gabrielfbdiniz/PFC-Boost-STM32/README.md

# AC-DC 380V Active Boost PFC Converter








Conversor estático de potência CA/CC com **Correção Ativa do Fator de Potência (Active PFC)** na topologia **Boost**, projetado para elevar a tensão da rede elétrica retificada (127V / 220V AC) para um barramento CC estabilizado de **380V DC**.

O controle digital de malha fechada (tensão e corrente em modo de condução contínua - CCM) e gerenciamento de estados é operado por uma plataforma **STM32F103C8T6 (ARM Cortex-M3 a 72 MHz)**, acompanhado de proteções ultrarrápidas de sobrecorrente por hardware e circuito inteligente de pré-carga (*soft-start / inrush current limiting*).

---

## Renderizações 3D do Projeto

| Vista Superior (Top View) | Vista Inferior (Bottom View) |
| :---: | :---: |
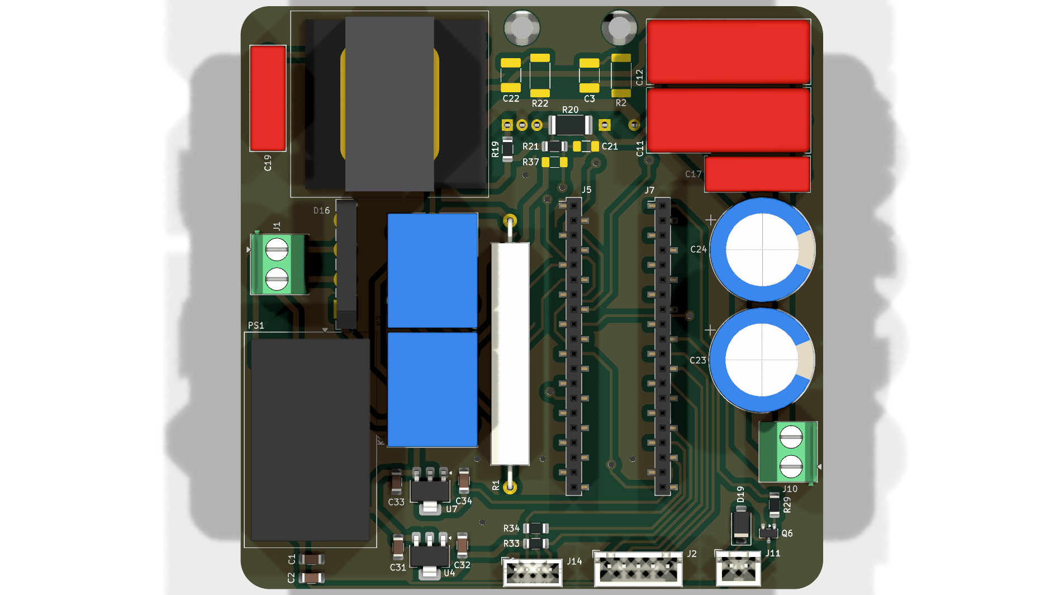
[picture p1: renders/render_top.png]
Top View
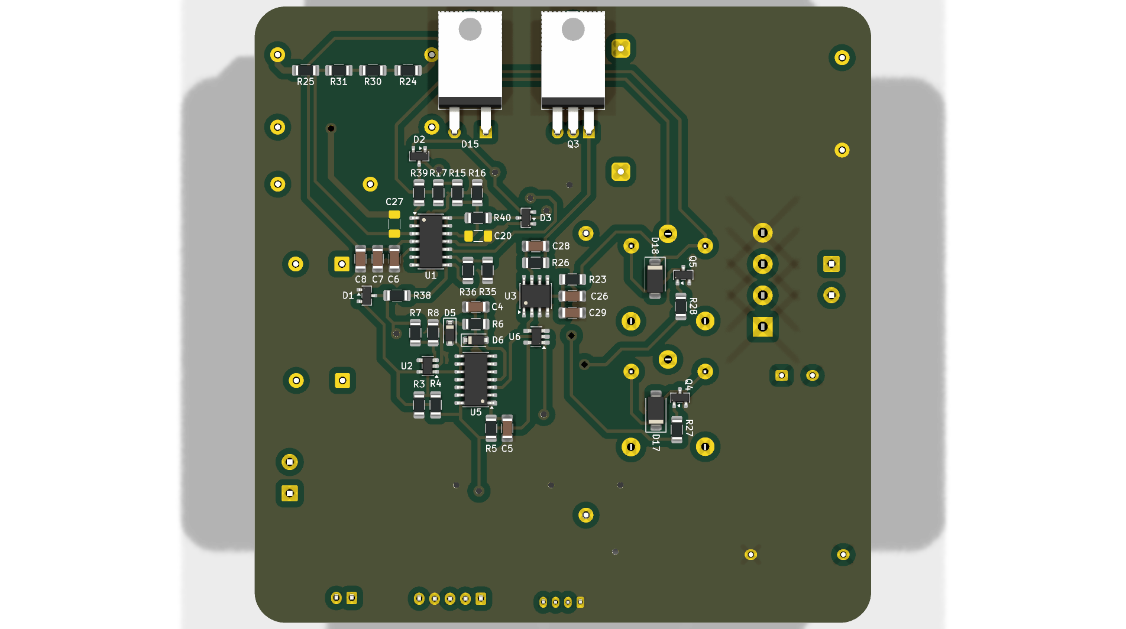
[picture p2: renders/render_bottom.png]
Bottom View
|  |  |

| Perspectiva Superior Isométrica | Perspectiva Inferior Isométrica |
| :---: | :---: |
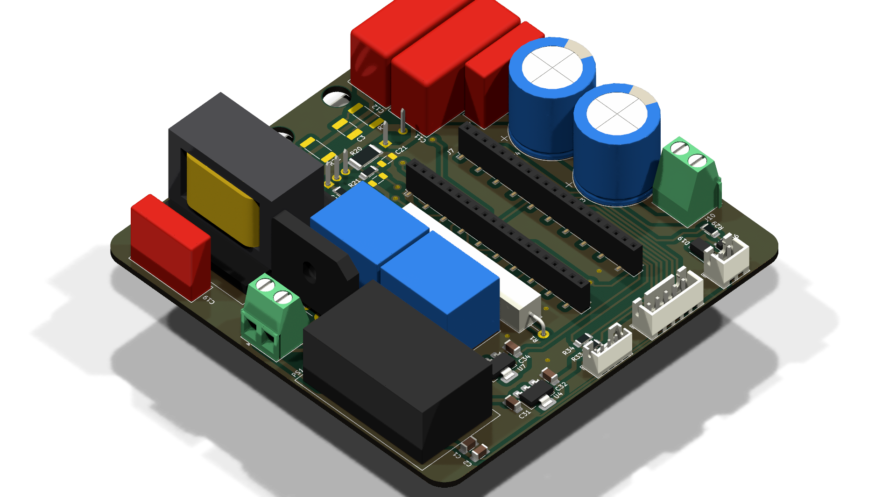
[picture p3: renders/render_iso_top.png]
Top Isometric
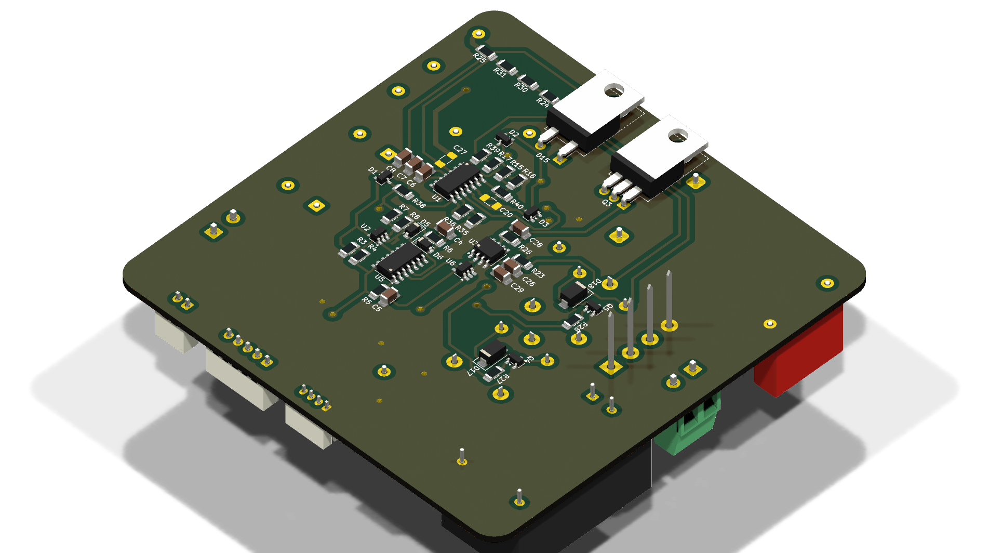
[picture p4: renders/render_iso_bottom.png]
Bottom Isometric
|  |  |

---

## 1. Visão Geral da Arquitetura do Conversor

O sistema é dividido em três blocos funcionais modulares conforme o esquemático hierárquico:
1. **Low Frequency Rectifier & Inrush (`lf_rectifier`):** Ponte retificadora de entrada, relé de bypass de inrush (`RELAY_INRUSH`) e relé mestre de ligamento (`RELAY_ON_OFF`).
2. **Estágio de Potência & Proteção PFC (`pfc`):** Indutor boost, MOSFET de comutação rápida, diodo boost ultrarrápido, gate driver com porta de intertravamento e latch analógico de sobrecorrente em hardware.
3. **Placa de Controle & IHM (`mcu`):** Breakout STM32F103 (Blue Pill), conversores de nível lógico, display I2C, encoder rotativo e acionamento térmico do ventilador.

```mermaid
flowchart LR
    subgraph AC_Input["Entrada de Rede"]
        AC["Rede CA (127V / 220V)"] --> INRUSH["Circuito de Pré-carga & Inrush"]
        INRUSH --> BRIDGE["Ponte Retificadora"]
    end

    subgraph PFC_Stage["Estágio Boost PFC (Alta Tensão)"]
        BRIDGE -->|"V_in retificada"| L["Indutor Boost L1"]
        L --> Q["MOSFET Q3"]
        L --> D["Diodo Boost D15"]
        D --> COUT["Banco Capacitivo (380V DC)"]
        Q --> SHUNT["Sensor de Corrente"]
    end

    subgraph Hardware_Protection["Proteção Hardware OCP"]
        SHUNT --> COMP["Comparador Rápido (LMV7219)"]
        COMP --> LATCH["Latch SR (74HC00)"]
        LATCH -->|"Hard-Trip Inibição"| AND_GATE["Porta AND (74LVC1G08)"]
        AND_GATE --> DRIVER["Gate Driver TC4427"]
        DRIVER --> Q
    end

    subgraph MCU_Control["Controle Digital (STM32 Blue Pill)"]
        COUT -.->|"Sensoriamento Vout (ADC)"| MCU["STM32F103C8T6"]
        BRIDGE -.->|"Sensoriamento Vin (ADC)"| MCU
        SHUNT -.->|"Sensoriamento IL (ADC)"| MCU
        MCU -->|"PWM Alta Frequência"| AND_GATE
        MCU -->|"RESET_OC"| LATCH
        MCU -->|"ENABLE Geral"| AND_GATE
        MCU -->|"Comando Relés"| INRUSH
    end
```

---

## 2. Especificações Técnicas

| Parâmetro | Valor / Faixa | Observações |
| :--- | :--- | :--- |
| **Topologia** | Boost PFC Ativo (CCM) | Fator de Potência $> 0.98$ |
| **Tensão de Entrada ($V_{in}$)** | $127\text{ V}_{\text{RMS}} - 220\text{ V}_{\text{RMS}}$ ($60\text{ Hz}$) | Tensão de pico retificada: $\approx 180\text{ V} - 311\text{ V}$ |
| **Tensão de Saída ($V_{out}$)** | **$380\text{ V DC}$ regulada** | Tensão nominal do barramento CC |
| **Controlador** | STM32F103C8T6 (ARM Cortex-M3) | 72 MHz, 64 KB Flash, ADC 12 bits |
| **Chaveamento Principal** | MOSFET TO-220 + Diodo Boost TO-220 | Dissipadores dimensionados para convecção forçada |
| **Driver de Gate** | Microchip TC4427 + Intertravamento 74LVC1G08 | Resposta sub-microssegundo |
| **Proteção de Sobrecorrente (OCP)** | Comparador LMV7219 + Latch 74HC00 | Desligamento por hardware independente do MCU |
| **Pré-carga de Barramento** | Relés de 2 estágios (`INRUSH` e `ON_OFF`) | Protege diodos e banco capacitivo na energização |
| **Interface do Usuário** | Display I2C + Encoder Rotativo com Push-Button | Navegação de menus, leituras e parametrização |
| **Refrigeração** | Saída controlada de 12V para Ventoinha | Acionamento via transistor comutada por PWM/GPIO |

---

## 3. Pinout & Mapeamento do Microcontrolador (STM32 Blue Pill)

O mapeamento de pinos reflete as conexões reais implementadas nas folhas esquemáticas em [`hardware/`](hardware/) e roteadas na placa de circuito impresso:

### Pinos de Potência, Controle e Atuadores

| Pino Blue Pill | Sinal Associado | Função no Hardware | Descrição / Operação |
| :--- | :--- | :--- | :--- |
| **`PA2`** | `PFC_PWM` | `TIM2_CH3` | Sinal PWM de alta frequência (50 a 100 kHz) para comutação do MOSFET via gate driver |
| **`PB10`** | `RELAY_INRUSH`| GPIO Output | Aciona o relé de limitação de corrente de partida (bypass do termistor NTC) |
| **`PB11`** | `RELAY_ON_OFF`| GPIO Output | Aciona o relé principal de energização da rede CA |
| **`PB12`** | `FAN_CTRL` | GPIO Output | Controle liga/desliga da ventoinha de refrigeração forçada |
| **`PB8`** | `I2C1_SCL` | `I2C1` | Clock do barramento serial I2C (Display OLED 0.96" SSD1306) com pull-up de 4.7kΩ |
| **`PB9`** | `I2C1_SDA` | `I2C1` | Dados do barramento serial I2C (Display OLED 0.96" SSD1306) com pull-up de 4.7kΩ |
| **`PB3`** | `EXP_SCK` | `SPI1_SCK` / GPIO | Barramento de expansão frontal / Interface de usuário (`J2`) |
| **`PB4`** | `EXP_MISO` | `SPI1_MISO` / GPIO | Barramento de expansão frontal / Interface de usuário (`J2`) |
| **`PB5`** | `EXP_MOSI` | `SPI1_MOSI` / GPIO | Barramento de expansão frontal / Interface de usuário (`J2`) |
| **`PA15`** | `EXP_CS` | GPIO Output | Chip-select para periféricos de expansão no conector `J2` |

### Sensoriamento Analógico e Medição

| Pino Blue Pill | Sinal Associado | Função no Hardware | Descrição / Operação |
| :--- | :--- | :--- | :--- |
| **`PA7`** | `PFC_IL` | `ADC1_IN7` | Sensoriamento analógico da corrente no indutor boost (amplificador de shunt) |
| **`PB0`** | `PFC_VOUT`| `ADC1_IN8` | Sensoriamento da tensão de saída do barramento CC estabilizado (380V) |
| **`PB1`** | `PFC_VIN` | `ADC1_IN9` | Sensoriamento da tensão senoidal retificada de entrada |
| **`PC13`** | *LED Onboard* | GPIO Output | LED indicador de batimento cardíaco (*heartbeat*) e status operacional |
| **`PA13`/`PA14`** | `SWD` | `SWDIO` / `SWCLK` | Interface de gravação e depuração em tempo real com ST-Link v2 |

## 4. Circuitos de Proteção e Segurança em Hardware

1. **Proteção Ultrarrápida de Sobrecorrente (Hardware Trip):**
   * Em conversores boost, sobrecorrentes na chave podem queimar semicondutores em microssegundos.
   * O sinal do resistor shunt de corrente é monitorado continuamente pelo comparador analógico **LMV7219** (`U2`).
   * A saída do comparador aciona imediatamente um **Latch SR implementado com portas NAND 74HC00** (`U5`), travando a saída em nível lógico baixo e cortando a porta AND `74LVC1G08` (`U6`) antes mesmo do firmware do MCU tomar conhecimento.
   * O destravamento após mitigação só ocorre mediante pulso explícito do pino `RESET_OC`.

2. **Sequenciamento de Energização e Pré-Carga:**
   * Na energização inicial, o relé `RELAY_INRUSH` comuta o fluxo de corrente por resistores limitadores de alta potência até os capacitores de saída carregarem sem picos destrutivos.
   * Ao atingir o patamar nominal de entrada, o relé mestre `RELAY_ON_OFF` fecha o circuito em paralelo e o conversor pode ser habilitado com segurança.

---

## 5. Estrutura do Repositório

```text
├── hardware/                   # Projeto de Hardware no KiCad 10
│   ├── 3d/                     # Modelos CAD 3D dos componentes (STEP / WRL)
│   │   ├── Capacitor_THT_L28.0mm_W11.0mm_P25.00mm.step # Modelo 3D dos capacitores C11 e C12
│   │   ├── Inductor_NEE-30-15-15.step                  # Modelo 3D do indutor boost L1 (NEE-30)
│   │   └── ...                 # Modelos adicionais (STM32 Blue Pill, bornes, conectores)
│   ├── lf_rectifier.kicad_sch  # Sub-folha: Retificação de baixa frequência e inrush
│   ├── mcu.kicad_sch           # Sub-folha: Módulo MCU Blue Pill e conexões de IHM
│   ├── pfc.kicad_sch           # Sub-folha: Estágio Boost PFC de 380V e circuitos de proteção
│   ├── power-supply.kicad_pcb  # Layout e roteamento completo da PCB
│   ├── power-supply.kicad_pro  # Arquivo de gerenciamento do projeto KiCad 10
│   └── power-supply.kicad_sch  # Esquemático principal (Top-Level Sheet)
├── firmware/                   # Firmware embarcado para STM32F103 (STM32CubeIDE 1.19)
│   └── README.md               # Guia de configuração, pinout, FSM e arquitetura
├── simulation/                 # Simulação computacional e controle
│   └── simulate_pfc_control.py # Comparação de malhas de controle (Cascata Energia vs. Jacobiano)
├── docs/                       # Documentação técnica e esquemáticos vetoriais
│   ├── PFC_380V_Schematic.pdf  # Esquemático completo exportado em PDF vetorial
│   └── pfc_control_comparison.png # Gráficos comparativos de controle
├── renders/                    # Renders 3D fotorrealistas em alta resolução (1080p)
│   ├── render_top.png
│   ├── render_bottom.png
│   ├── render_iso_top.png
│   └── render_iso_bottom.png
├── .gitignore                  # Filtro para temporários, builds e caches
├── LICENSE                     # Licença de Hardware Aberto CERN-OHL-S v2
└── README.md                   # Documentação técnica de engenharia
```

---

## 6. Como Abrir e Validar o Projeto

### Pré-requisitos
* **KiCad EDA 10.0+** instalado no sistema.
* **Python 3.10+** (com `numpy` e `matplotlib`) para as simulações numéricas.
* **STM32CubeIDE 1.19** para o desenvolvimento do firmware.

### Regenerar Renderizações 3D (via Linha de Comando)
```bash
kicad-cli pcb render -o renders/render_top.png --width 1920 --height 1080 --side top --quality high hardware/power-supply.kicad_pcb
kicad-cli pcb render -o renders/render_bottom.png --width 1920 --height 1080 --side bottom --quality high hardware/power-supply.kicad_pcb
kicad-cli pcb render -o renders/render_iso_top.png --width 1920 --height 1080 --rotate -45,0,45 --quality high hardware/power-supply.kicad_pcb
kicad-cli pcb render -o renders/render_iso_bottom.png --width 1920 --height 1080 --side bottom --rotate -45,0,45 --quality high hardware/power-supply.kicad_pcb
```

### Exportar Esquemático em PDF
```bash
kicad-cli sch export pdf -o docs/PFC_380V_Schematic.pdf hardware/power-supply.kicad_sch
```

### Executar a Simulação Comparativa de Controle
```bash
python simulation/simulate_pfc_control.py
```

## 7. Licença & Créditos

### Autores & Desenvolvedores
* **Abílio Davi**
* **Gabriel Diniz**
* **Vinicius Moreira**

### Orientação
* **Professor Colombo**
* **Professor Eduardo Lenz**

---

### Licença
Distribuído sob a licença **CERN-OHL-S v2** (*CERN Open Hardware Licence Strongly Reciprocal*). Consulte o arquivo [LICENSE](LICENSE) para mais detalhes.
