gabrielfbdiniz/PFC-Boost-STM32/docs/pfc_control_comparison.png

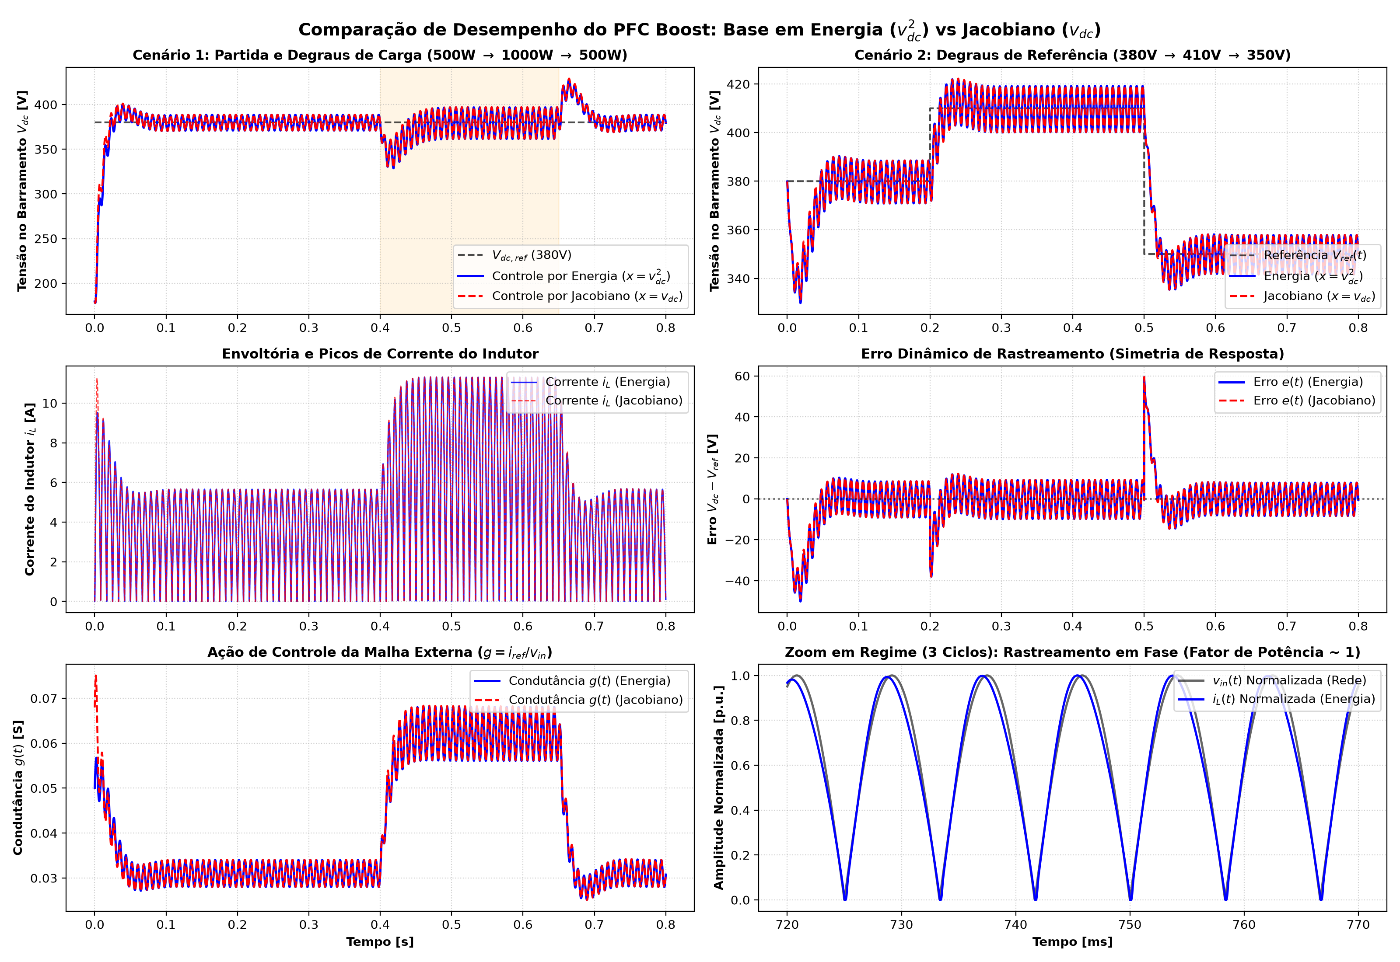
docs/pfc_control_comparison.png
