gabrielfbdiniz/PFC-Boost-STM32/hardware/3d/Capacitor_THT_L28.0mm_W11.0mm_P25.00mm.step

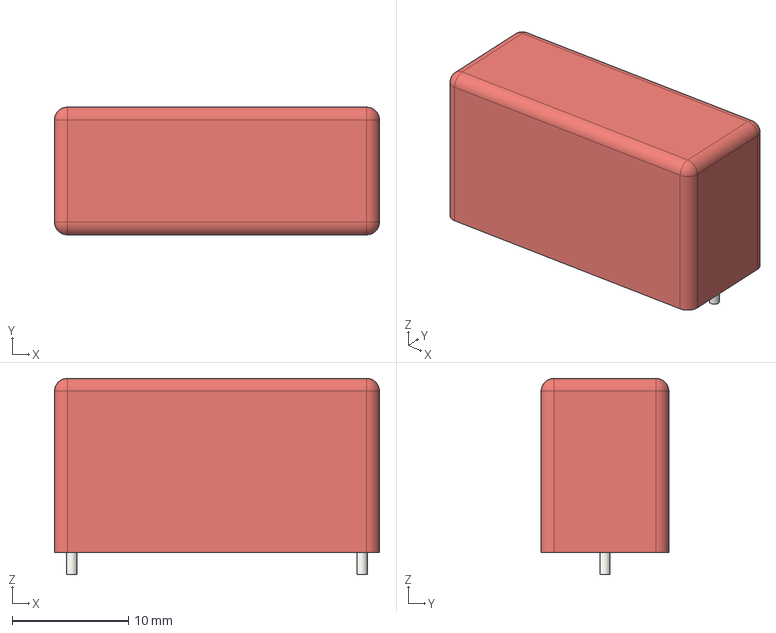
[picture p6: CAD file, 2026-11-01]
hardware/3d/Capacitor_THT_L28.0mm_W11.0mm_P25.00mm.step
28.0 x 11.0 x 16.9 mm
