gabrielfbdiniz/PFC-Boost-STM32/hardware/3d/Inductor_NEE-30-15-15.step

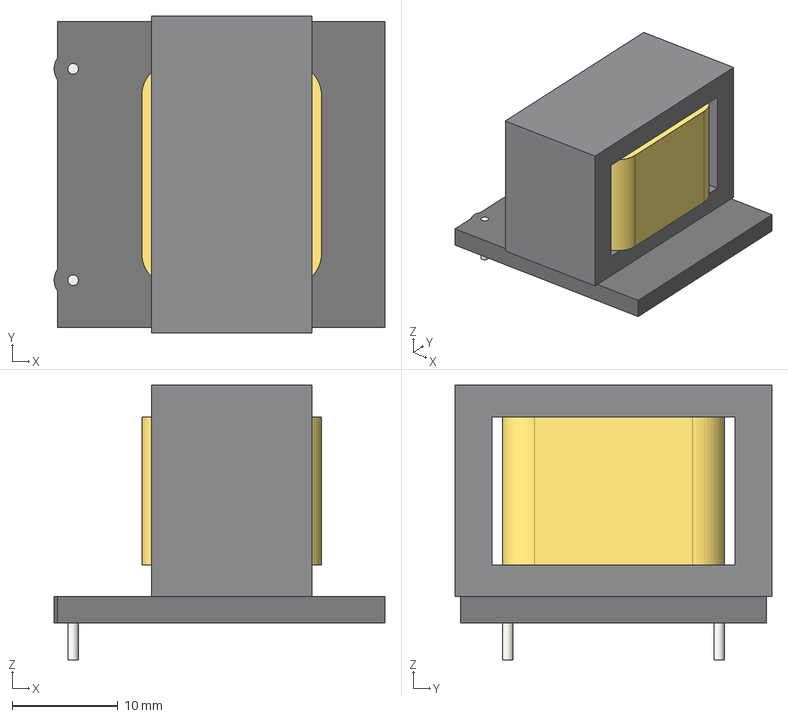
[picture p7: CAD file, 2026-11-01]
hardware/3d/Inductor_NEE-30-15-15.step
31.3 x 30.0 x 26.0 mm
