gabrielfbdiniz/PFC-Boost-STM32/hardware/3d/FuseHolder 5x20mm.step

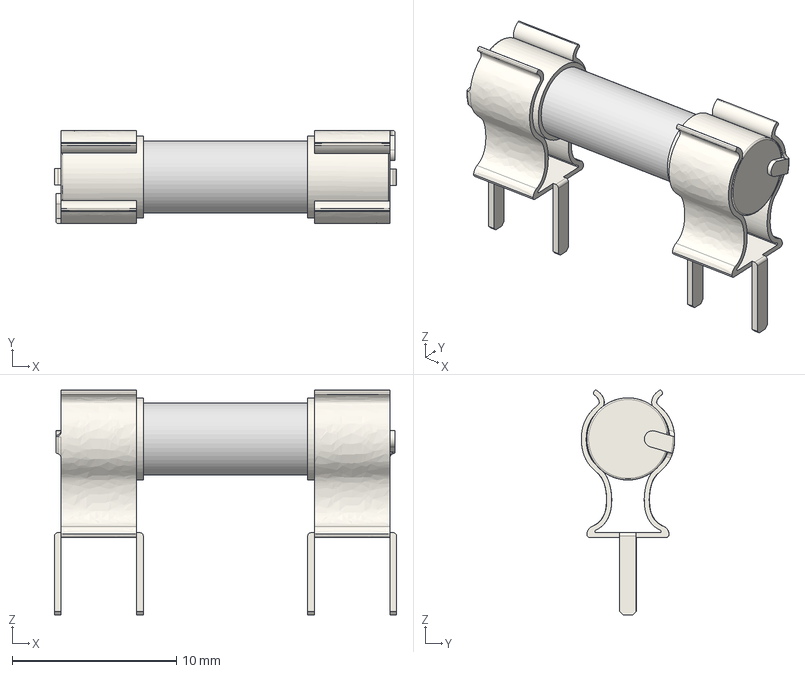
[picture p8: CAD file, 2026-06-02]
hardware/3d/FuseHolder 5x20mm.step
20.8 x 5.68 x 13.7 mm
