gabrielfbdiniz/PFC-Boost-STM32/hardware/3d/Blue Pill STM32.step

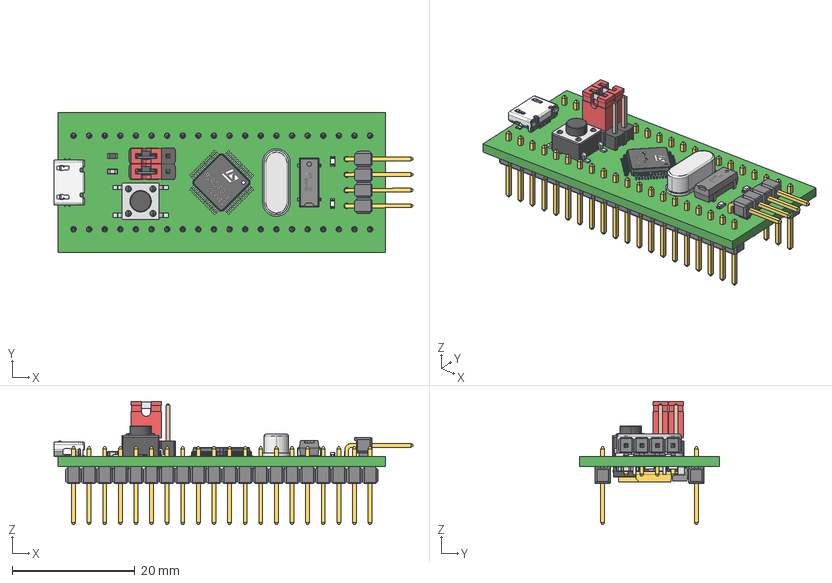
[picture p9: CAD file, 2026-06-02]
hardware/3d/Blue Pill STM32.step
58.4 x 22.9 x 20.1 mm
Pin1 x 12
Pin2 x 12
CeramicBody x 12
RES0603 x 11
pin_header_1x3_and_jumper x 2
STM32-LQFP48
User_Library-mc-306_crystal
USB_micro
User_Library-LED_SMD0603 x 2
C_6032-28 x 8
User_Library-DO-214AC_SMA
CircuitWorks-SOT-223
