gabrielfbdiniz/PFC-Boost-STM32/hardware/3d/DG308-2.54-06P-14-00AH.STEP

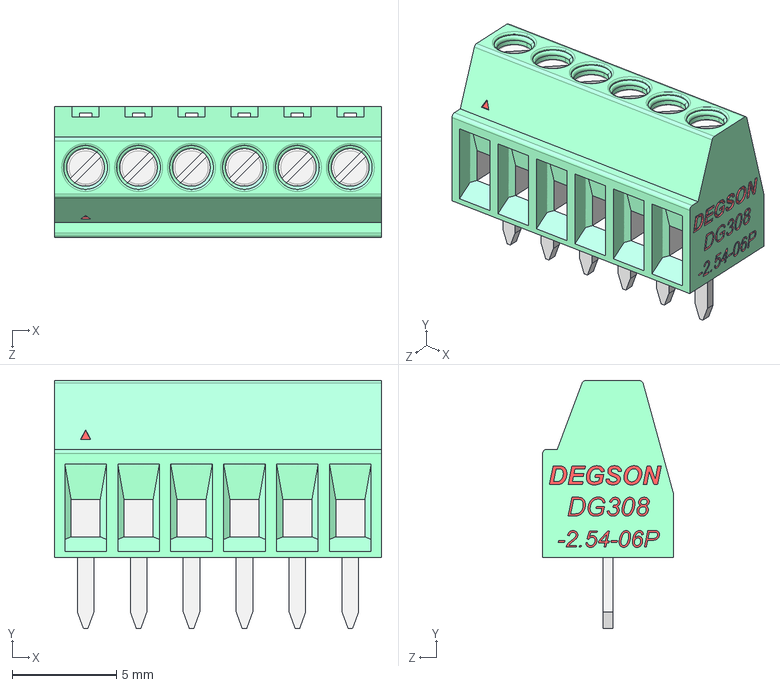
[picture p10: CAD file, 2026-06-02]
hardware/3d/DG308-2.54-06P-14-00AH.STEP
15.7 x 11.9 x 6.27 mm
