gabrielfbdiniz/PFC-Boost-STM32/docs/PFC_380V_Schematic.pdf

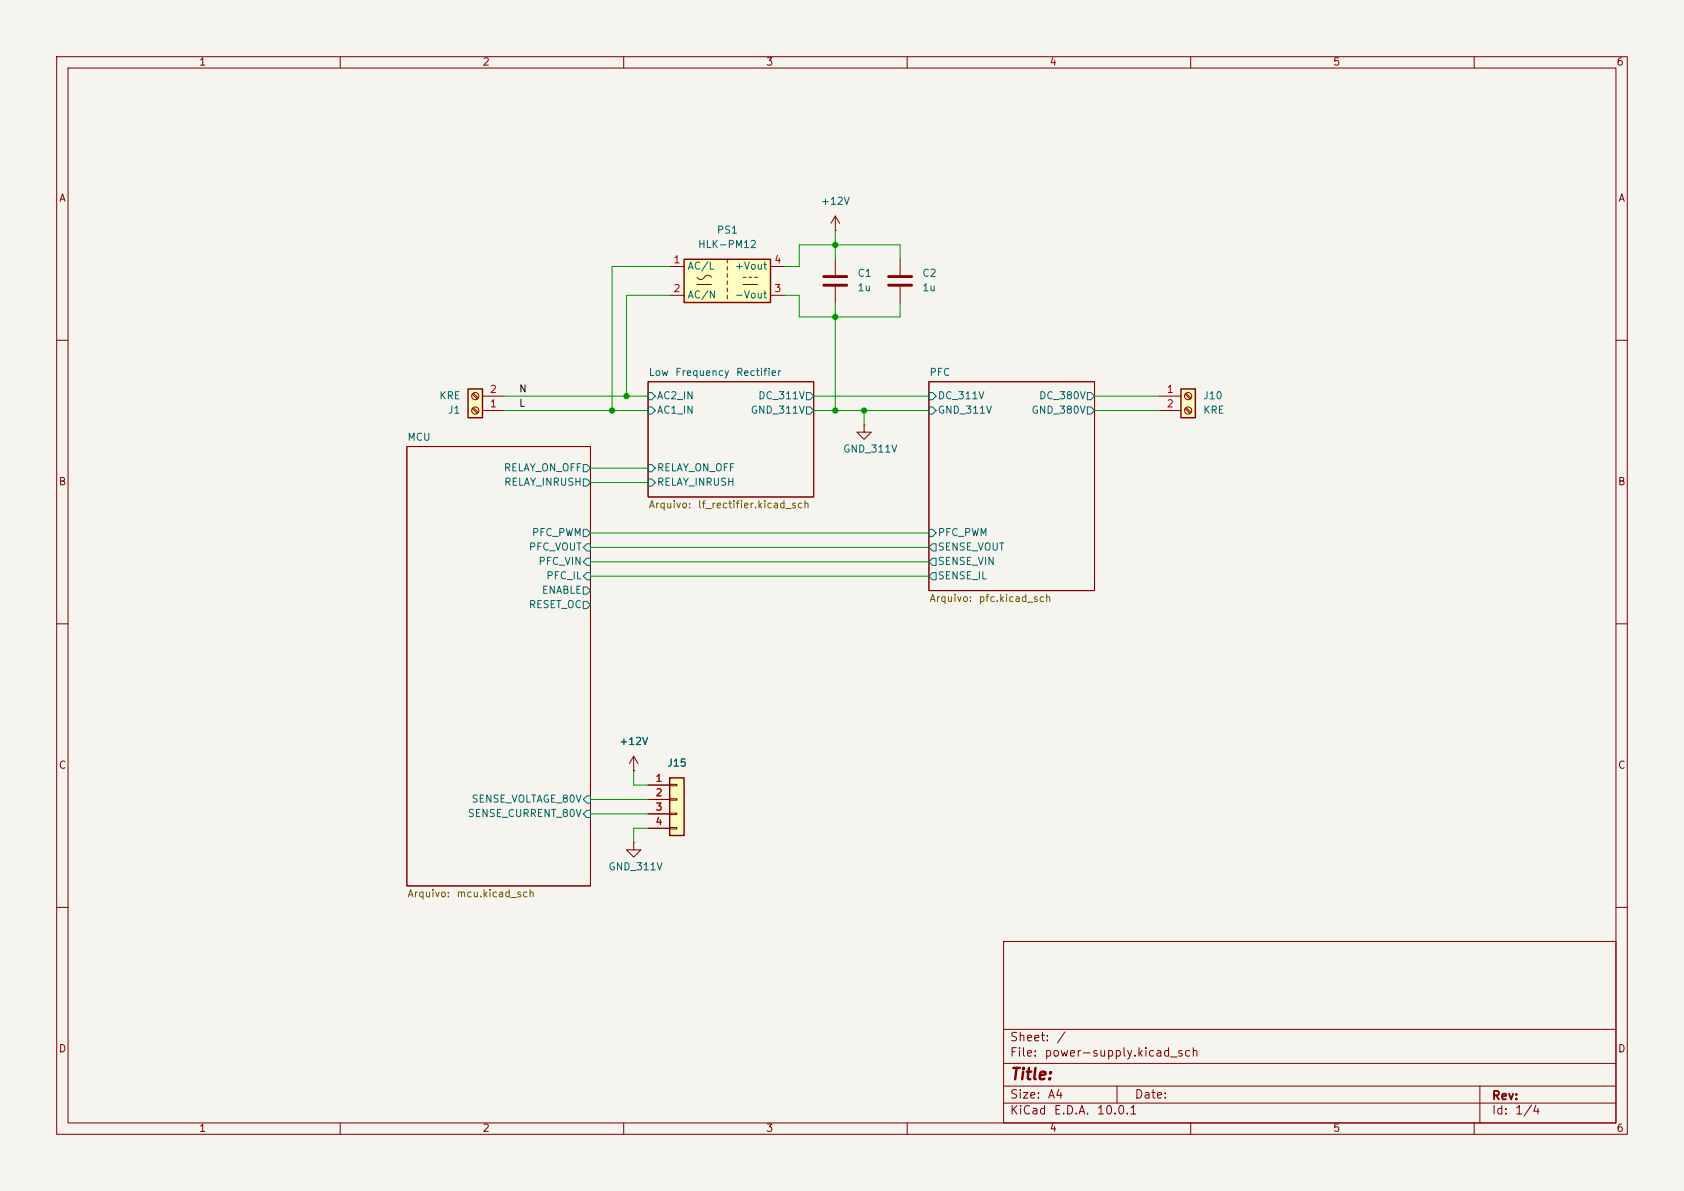
[picture p11: page 1]

Low Frequency Rectifier Arquivo: lf_rectifier.kicad_sch RELAY_INRUSH

Size: A4 | Rev:
KiCad E.D.A. 10.0.1 | Id: 1/4

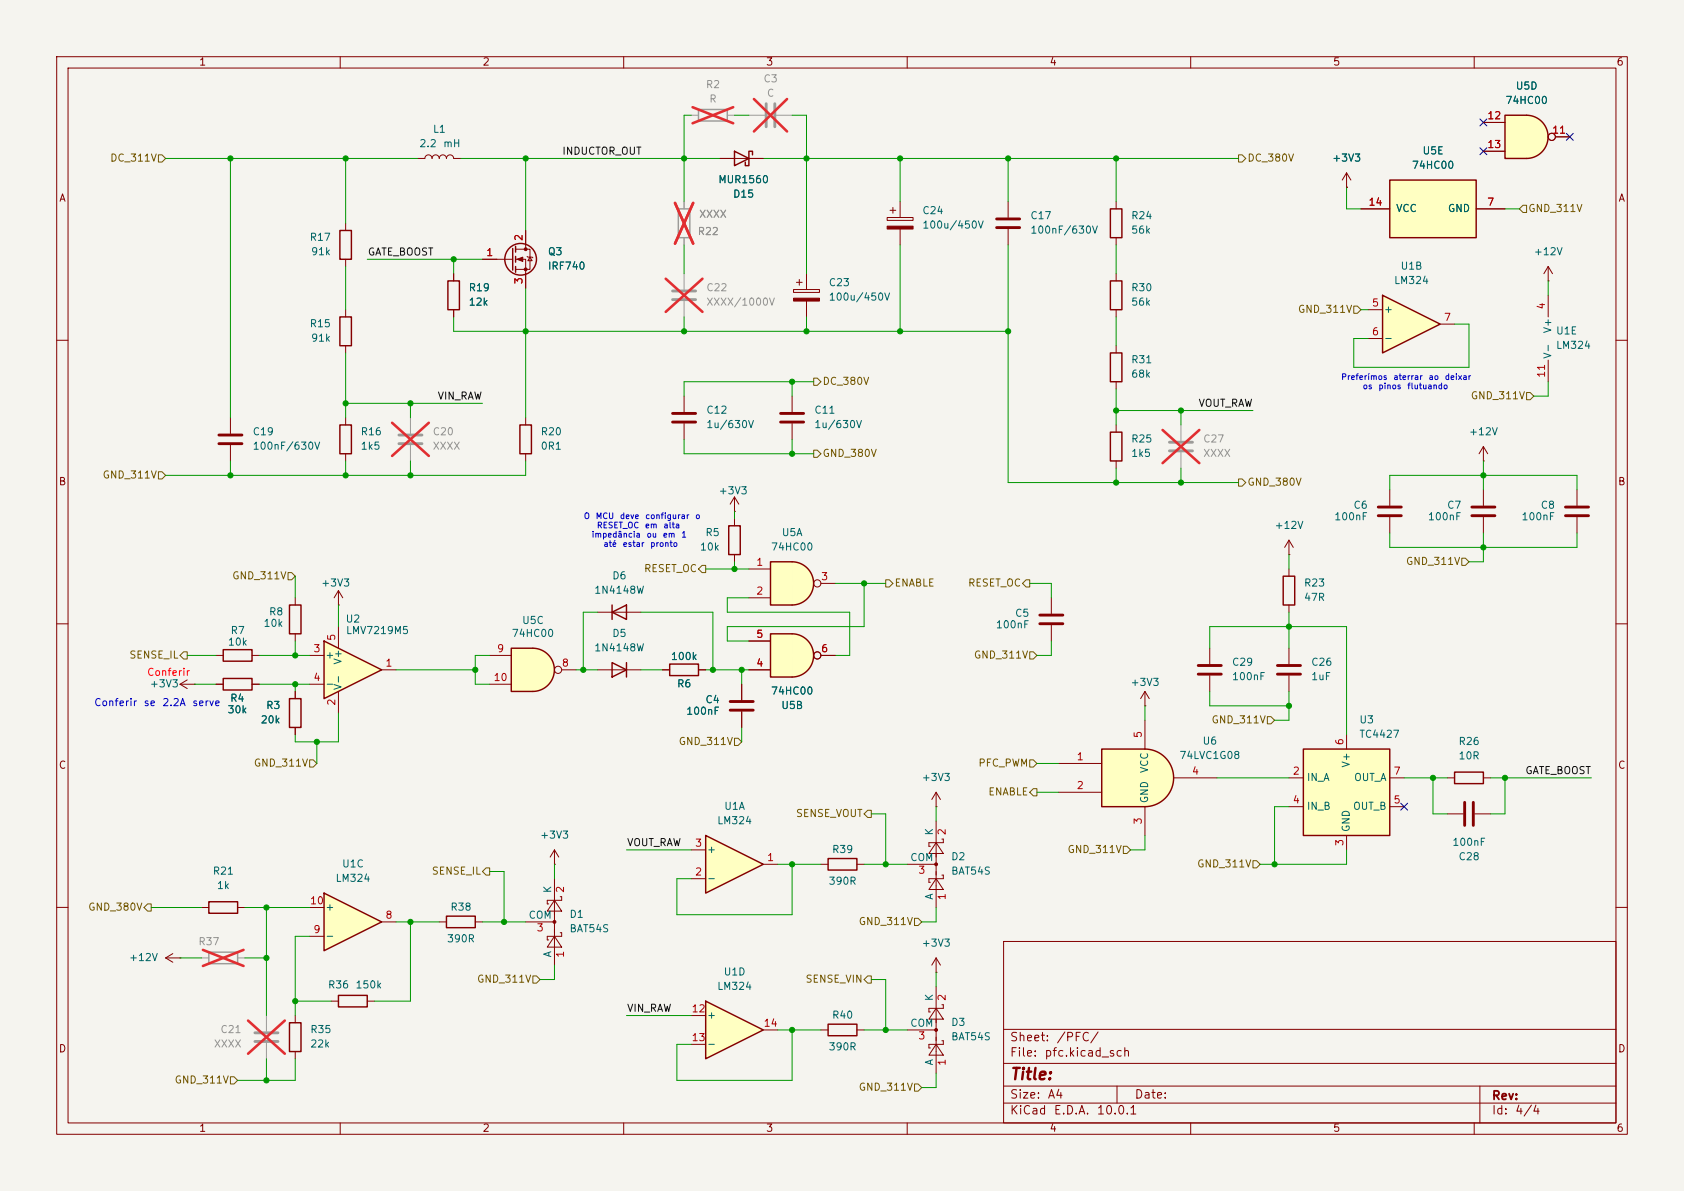
[picture p12: page 2]

impedância ou em 1 até estar pronto R4

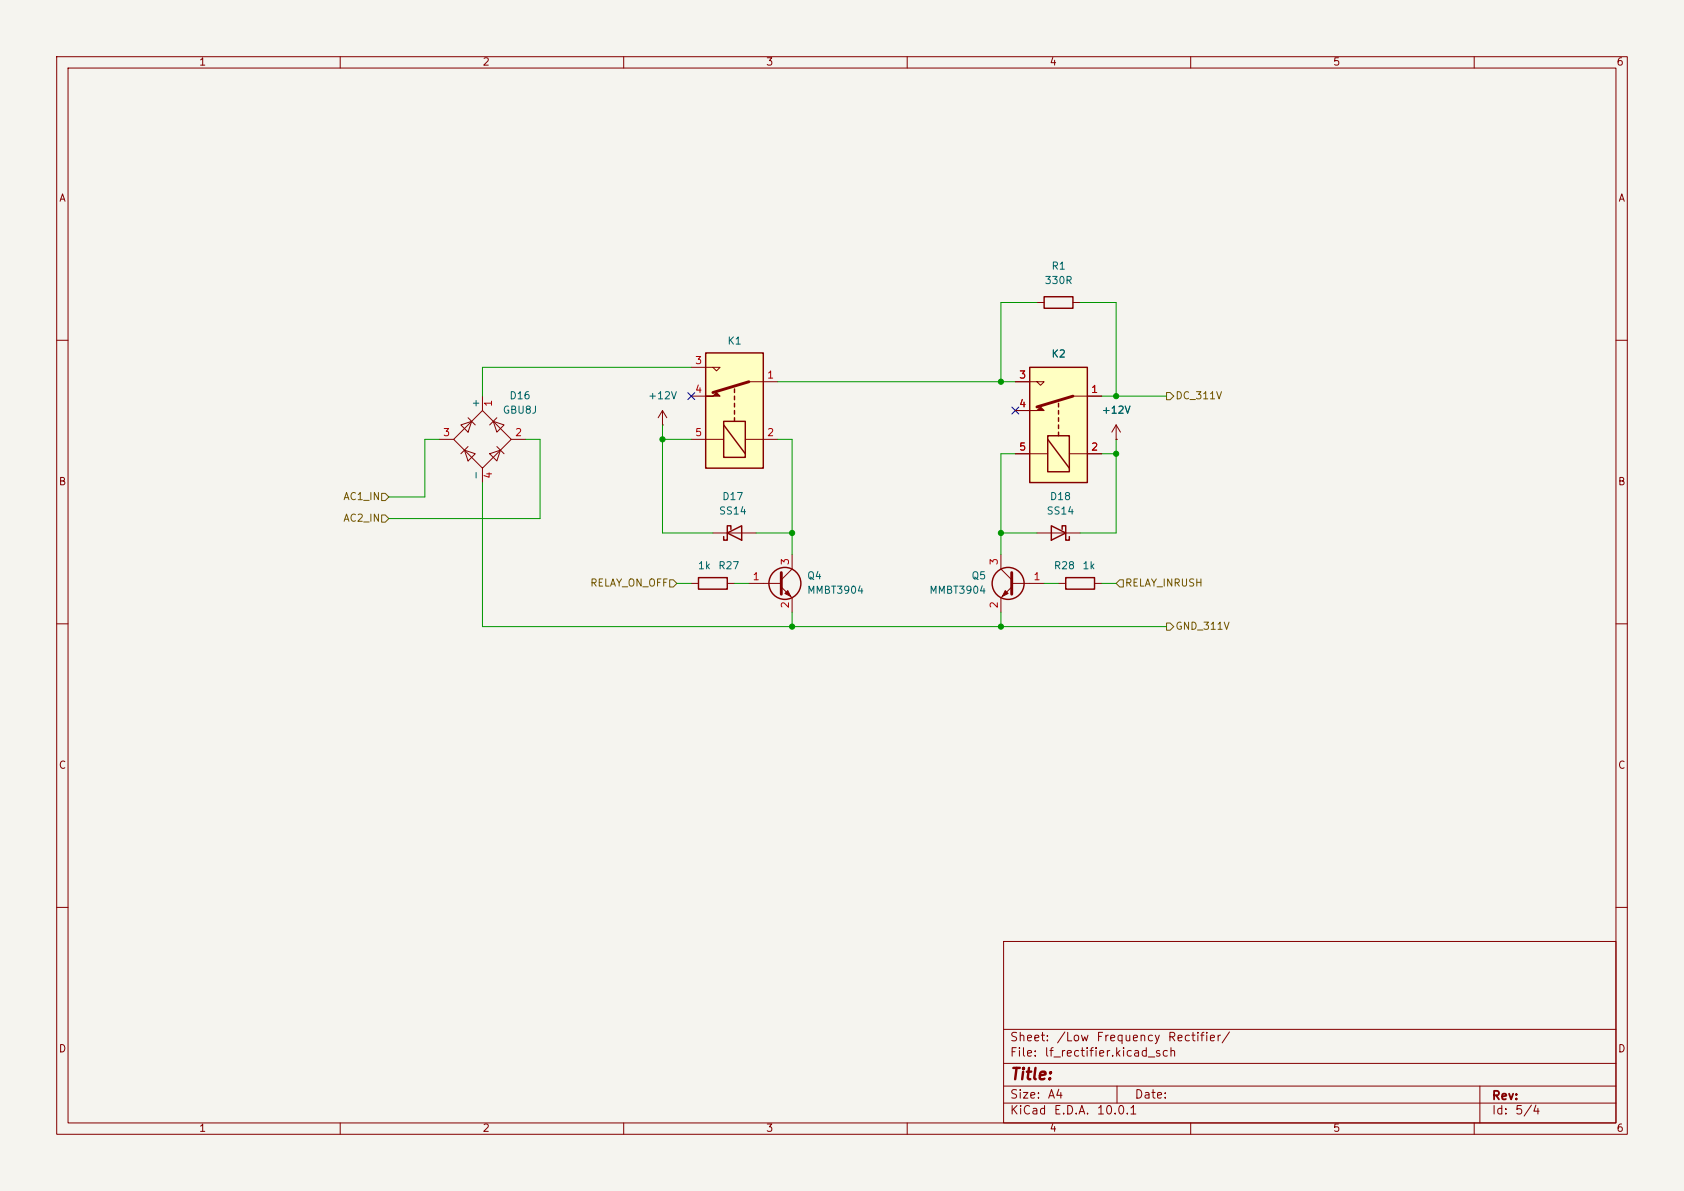
[picture p13: page 3]

Sheet: /Low Frequency Rectifier/
File: lf_rectifier.kicad_sch
Title:

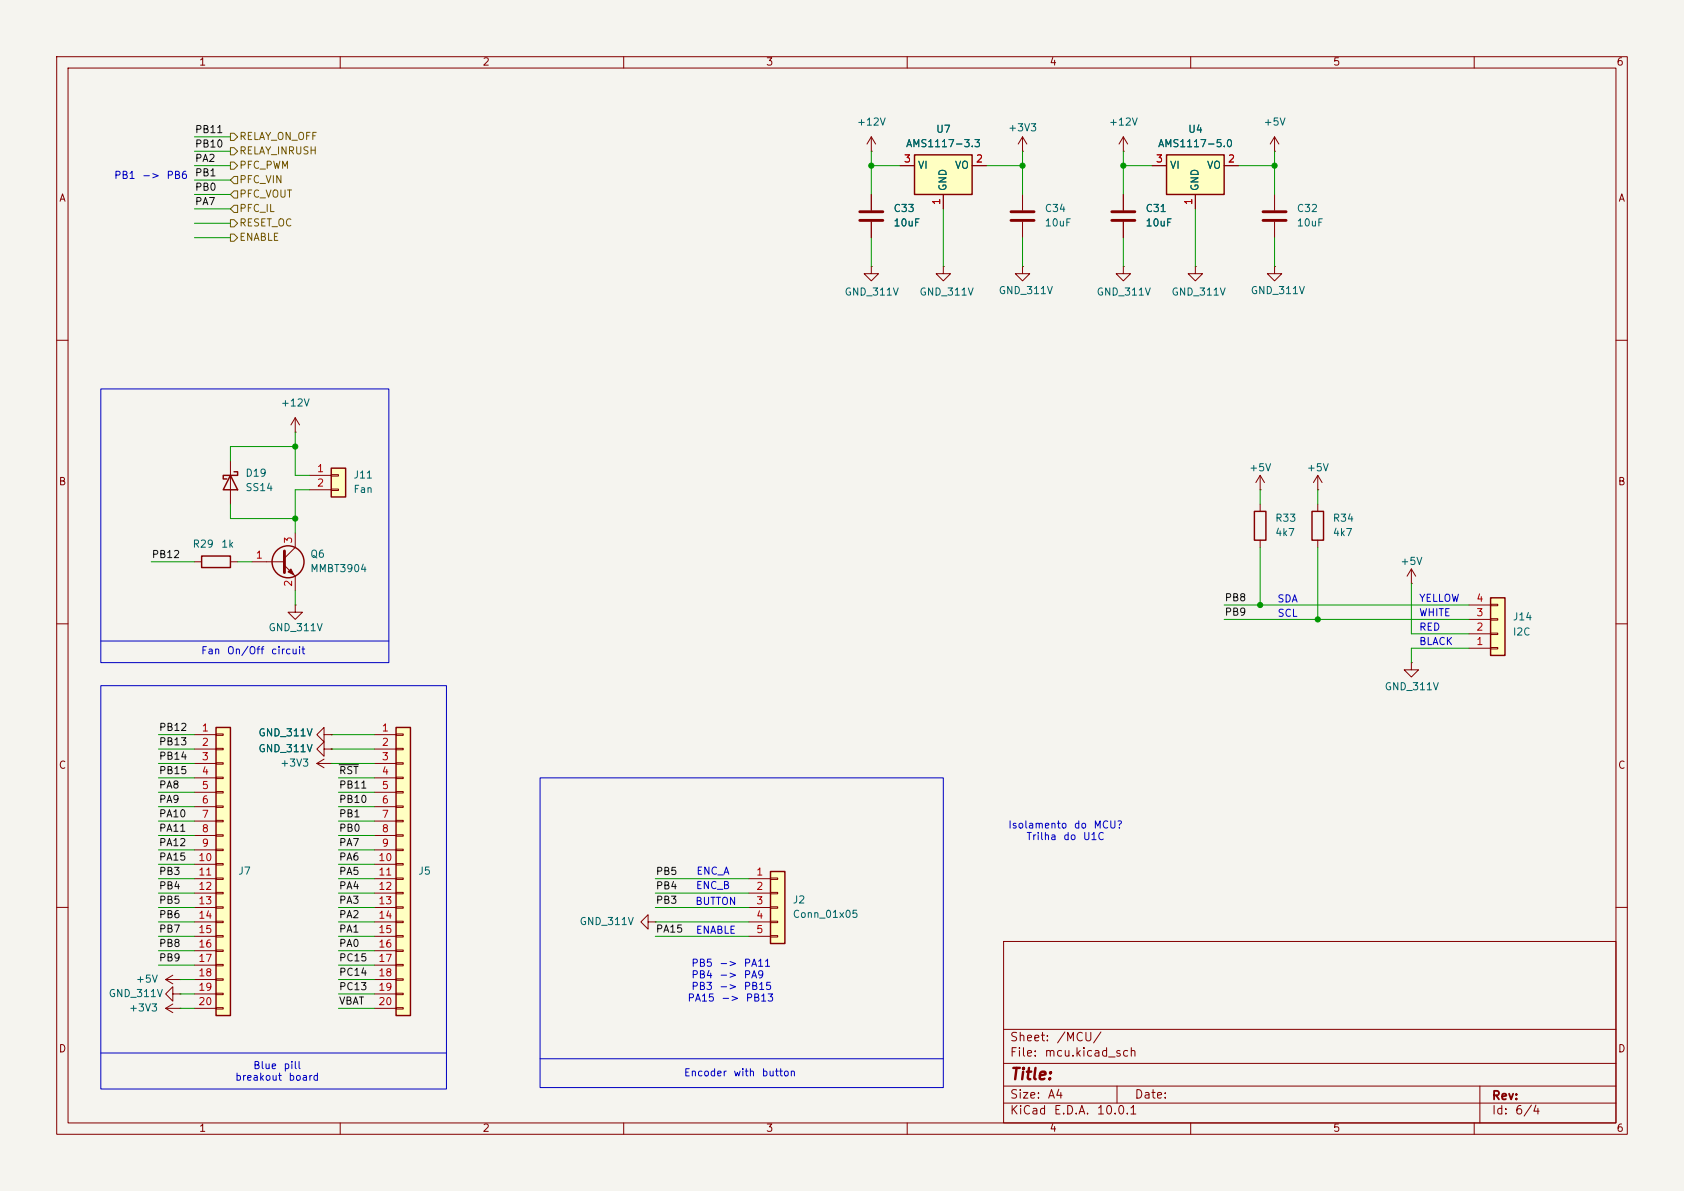
[picture p14: page 4]
