gabrielfbdiniz/PFC-Boost-STM32/hardware/power-supply.kicad_pcb

## KiCad design hardware/power-supply.kicad_pcb (2026-11-01)

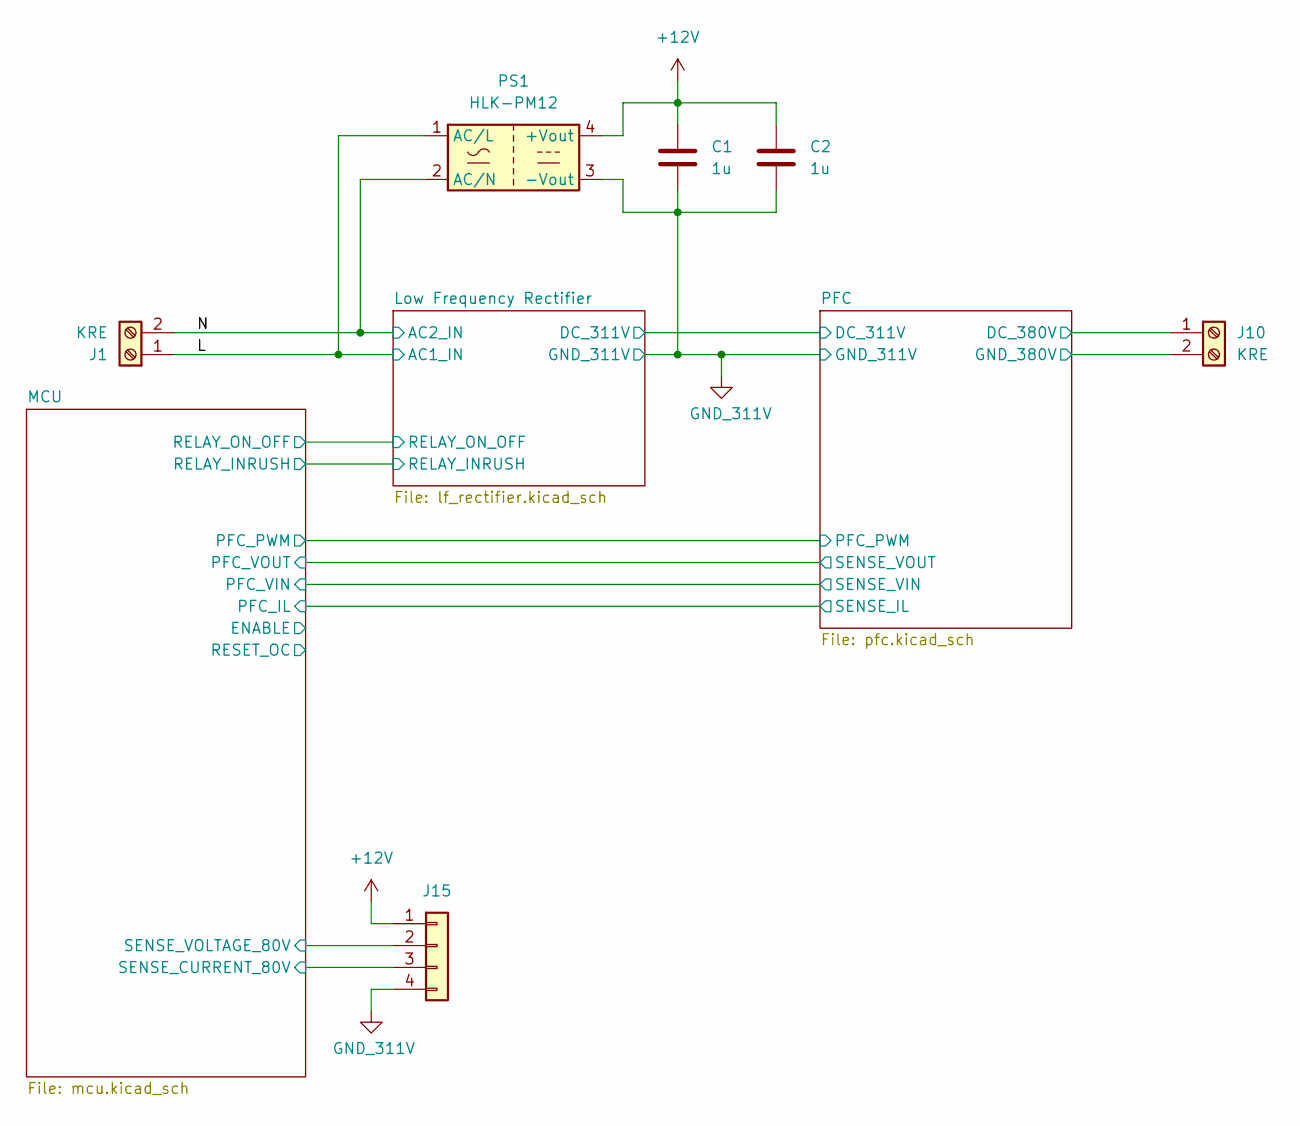
[picture p15: schematic power-supply.kicad_sch]

Parts:
C1, C2: 1u; C_1206_3216Metric_Pad1.33x1.80mm_HandSolder
J1, J10: KRE; TerminalBlock_Phoenix_MKDS-1,5-2-5.08_1x02_P5.08mm_Horizont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
J15: Conn_01x04; JST_PH_B4B-PH-K_1x04_P2.00mm_Vertical
PS1: HLK-PM12; Converter_ACDC_Hi-Link_HLK-PMxx

Connections:
+12V: C1.1, C2.1, J15.1, PS1.4 (+Vout); also elsewhere on the board
/L: J1.1, PS1.1 (AC/L); also elsewhere on the board
/N: J1.2, PS1.2 (AC/N); also elsewhere on the board
/PFC/DC_380V: J10.1; also elsewhere on the board
/PFC/GND_380V: J10.2; also elsewhere on the board
GND_311V: C1.2, C2.2, J15.4, PS1.3 (-Vout); also elsewhere on the board

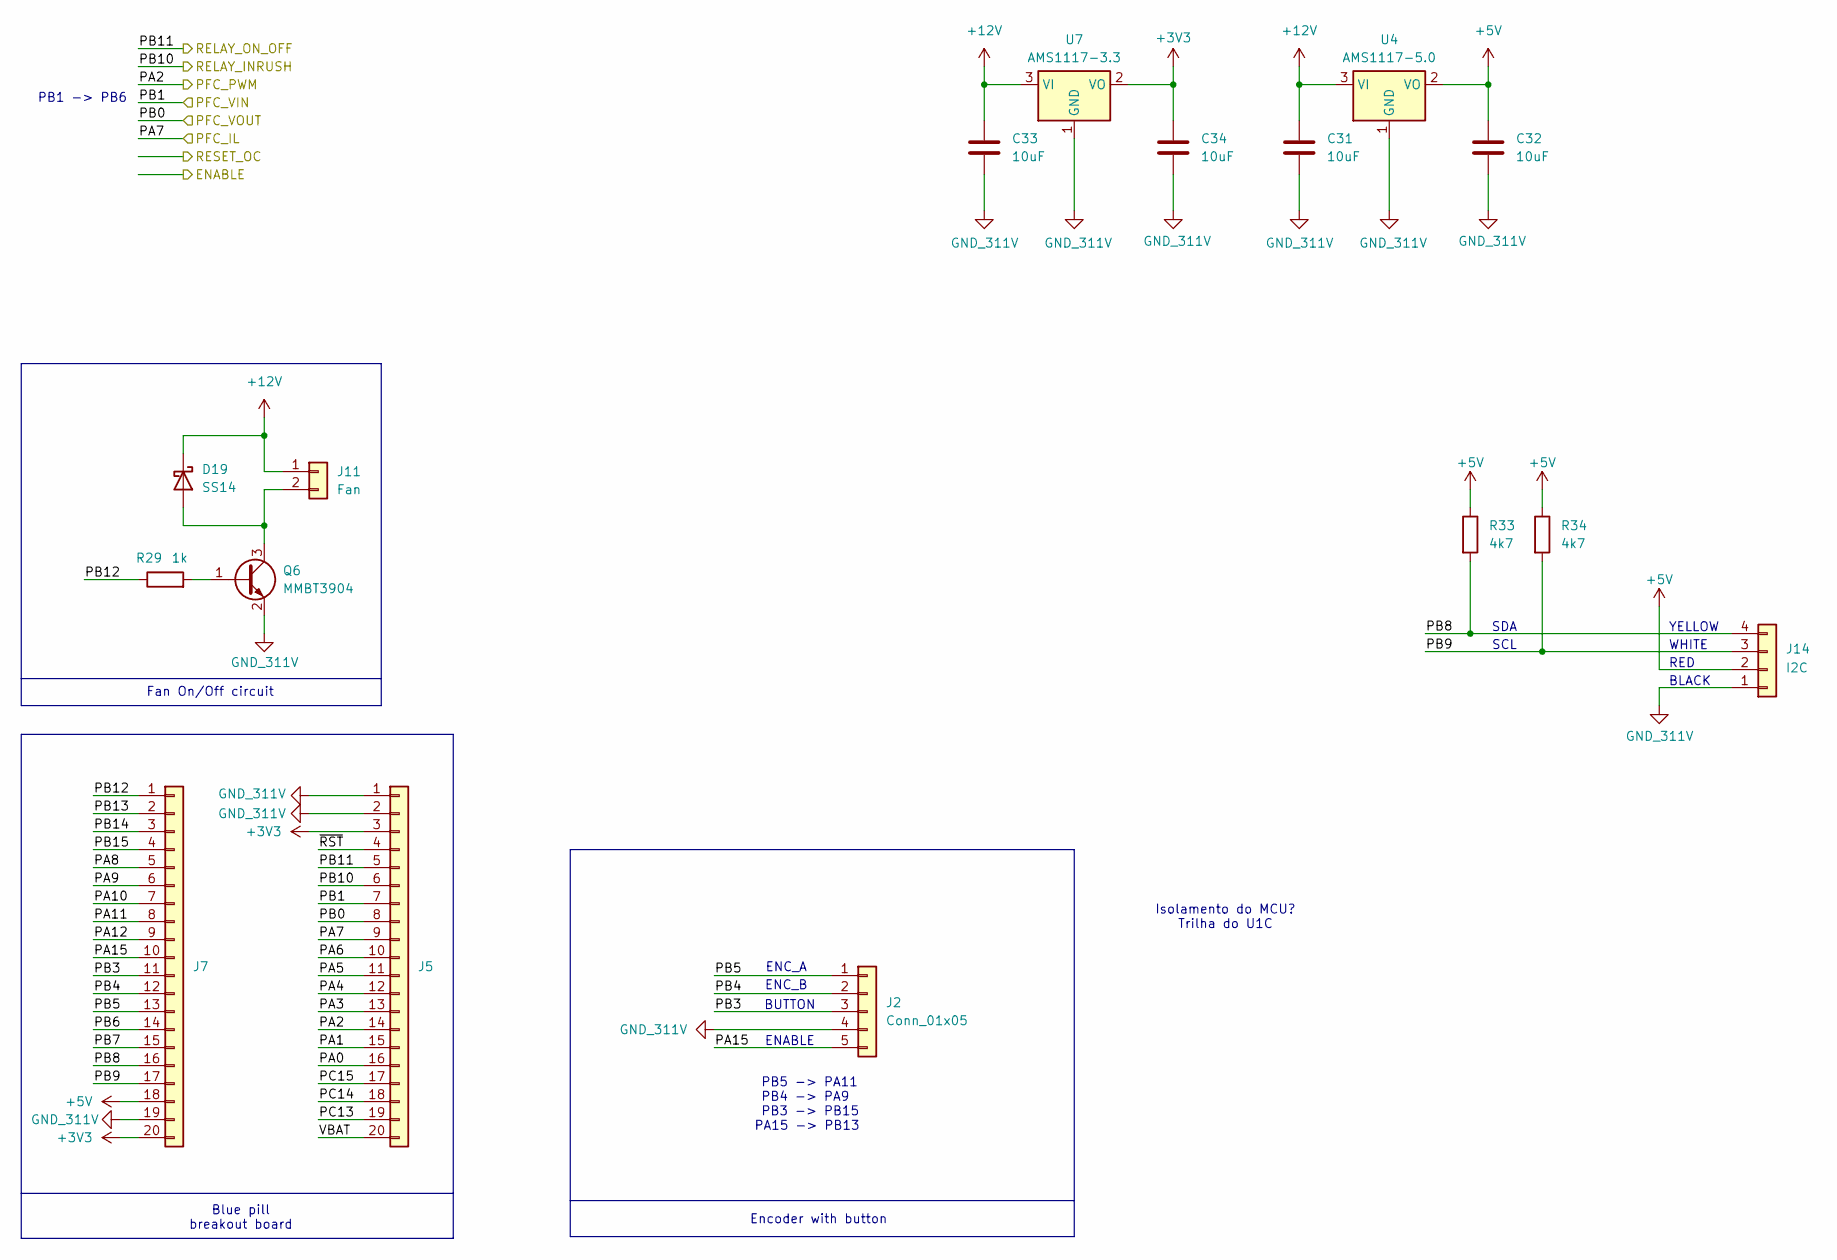
[picture p16: schematic mcu.kicad_sch]

Parts:
C31, C32, C33, C34: 10uF; C_1206_3216Metric_Pad1.33x1.80mm_HandSolder
D19: SS14; D_SMA
J2: Conn_01x05; JST_XH_B5B-XH-A_1x05_P2.50mm_Vertical
J5, J7: Conn_01x20; PinSocket_1x20_P2.54mm_Vertical_SMD_Pin1Left
J11: Fan; JST_XH_B2B-XH-A_1x02_P2.50mm_Vertical
J14: I2C; JST_PH_B4B-PH-K_1x04_P2.00mm_Vertical; LCSC C144395
Q6: MMBT3904; SOT-23
R29: 1k; R_1206_3216Metric_Pad1.30x1.75mm_HandSolder
R33, R34: 4k7; R_1206_3216Metric_Pad1.30x1.75mm_HandSolder; LCSC C26041
U4: AMS1117-5.0; SOT-223-3_TabPin2
U7: AMS1117-3.3; SOT-223-3_TabPin2

Connections:
+3V3: C34.1, J5.3, J7.20, U7.2 (VO); also elsewhere on the board
+5V: C32.1, J7.18, J14.2, R33.1, R34.1, U4.2 (VO)
+12V: C31.1, C33.1, D19.1 (K), J11.1, U4.3 (VI), U7.3 (VI); also elsewhere on the board
/MCU/PA0: J5.16
/MCU/PA1: J5.15
/MCU/PA2: J5.14; also elsewhere on the board
/MCU/PA3: J5.13
/MCU/PA4: J5.12
/MCU/PA5: J5.11
/MCU/PA6: J5.10
/MCU/PA7: J5.9; also elsewhere on the board
/MCU/PA8: J7.5
/MCU/PA9: J7.6
/MCU/PA10: J7.7
/MCU/PA11: J7.8
/MCU/PA12: J7.9
/MCU/PA15: J2.5, J7.10
/MCU/PB0: J5.8; also elsewhere on the board
/MCU/PB1: J5.7; also elsewhere on the board
/MCU/PB3: J2.3, J7.11
/MCU/PB4: J2.2, J7.12
/MCU/PB5: J2.1, J7.13
/MCU/PB6: J7.14
/MCU/PB7: J7.15
/MCU/PB8: J7.16, J14.4, R33.2
/MCU/PB9: J7.17, J14.3, R34.2
/MCU/PB10: J5.6; also elsewhere on the board
/MCU/PB11: J5.5; also elsewhere on the board
/MCU/PB12: J7.1, R29.1
/MCU/PB13: J7.2
/MCU/PB14: J7.3
/MCU/PB15: J7.4
/MCU/PC13: J5.19
/MCU/PC14: J5.18
/MCU/PC15: J5.17
/MCU/VBAT: J5.20
/MCU/~RST: J5.4
GND_311V: C31.2, C32.2, C33.2, C34.2, J2.4, J5.1, J5.2, J7.19, J14.1, Q6.2 (E), U4.1 (GND), U7.1 (GND); also elsewhere on the board
unnamed: D19.2 (A), J11.2, Q6.3 (C)
unnamed: Q6.1 (B), R29.2

Notes on the sheet:
SDA
YELLOW
RED
Blue pill breakout board
ENABLE
Fan On/Off circuit
ENC_A
Isolamento do MCU? Trilha do U1C
Encoder with button
ENC_B
BUTTON
SCL
PB1 -> PB6
BLACK
WHITE
PB5 -> PA11 PB4 -> PA9 PB3 -> PB15 PA15 -> PB13

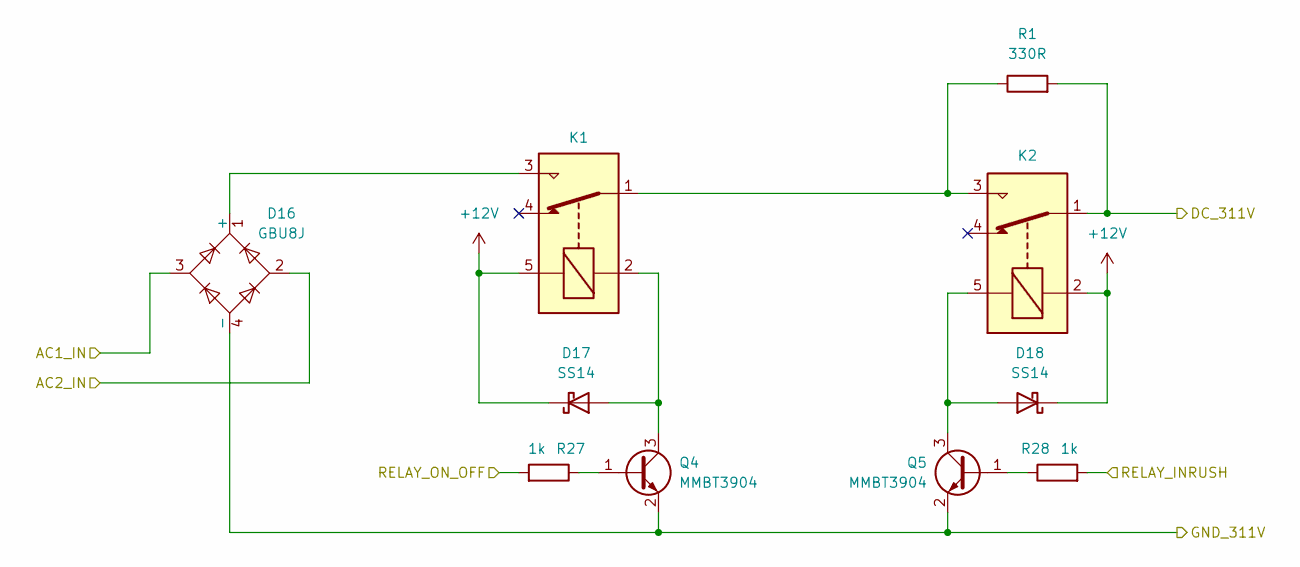
[picture p17: schematic lf_rectifier.kicad_sch]

Parts:
D16: GBU8J; Diode_Bridge_Vishay_GBU
D17, D18: SS14; D_SMA
K1, K2: Rele 5V; Relay_SPDT_SANYOU_SRD_Series_Form_C
Q4, Q5: MMBT3904; SOT-23
R1: 330R; R_Axial_Power_L38.0mm_W6.4mm_P45.72mm
R27, R28: 1k; R_1206_3216Metric_Pad1.30x1.75mm_HandSolder

Connections:
+12V: D17.1 (K), D18.1 (K), K1.5, K2.2; also elsewhere on the board
/L: D16.3; also elsewhere on the board
/Low Frequency Rectifier/DC_311V: K2.1, R1.2; also elsewhere on the board
/MCU/PB10: R28.2; also elsewhere on the board
/MCU/PB11: R27.2; also elsewhere on the board
/N: D16.2; also elsewhere on the board
GND_311V: D16.4 (-), Q4.2 (E), Q5.2 (E); also elsewhere on the board
unnamed: D16.1 (+), K1.3
unnamed: D17.2 (A), K1.2, Q4.3 (C)
unnamed: D18.2 (A), K2.5, Q5.3 (C)
unnamed: K1.1, K2.3, R1.1
unnamed: Q4.1 (B), R27.1
unnamed: Q5.1 (B), R28.1

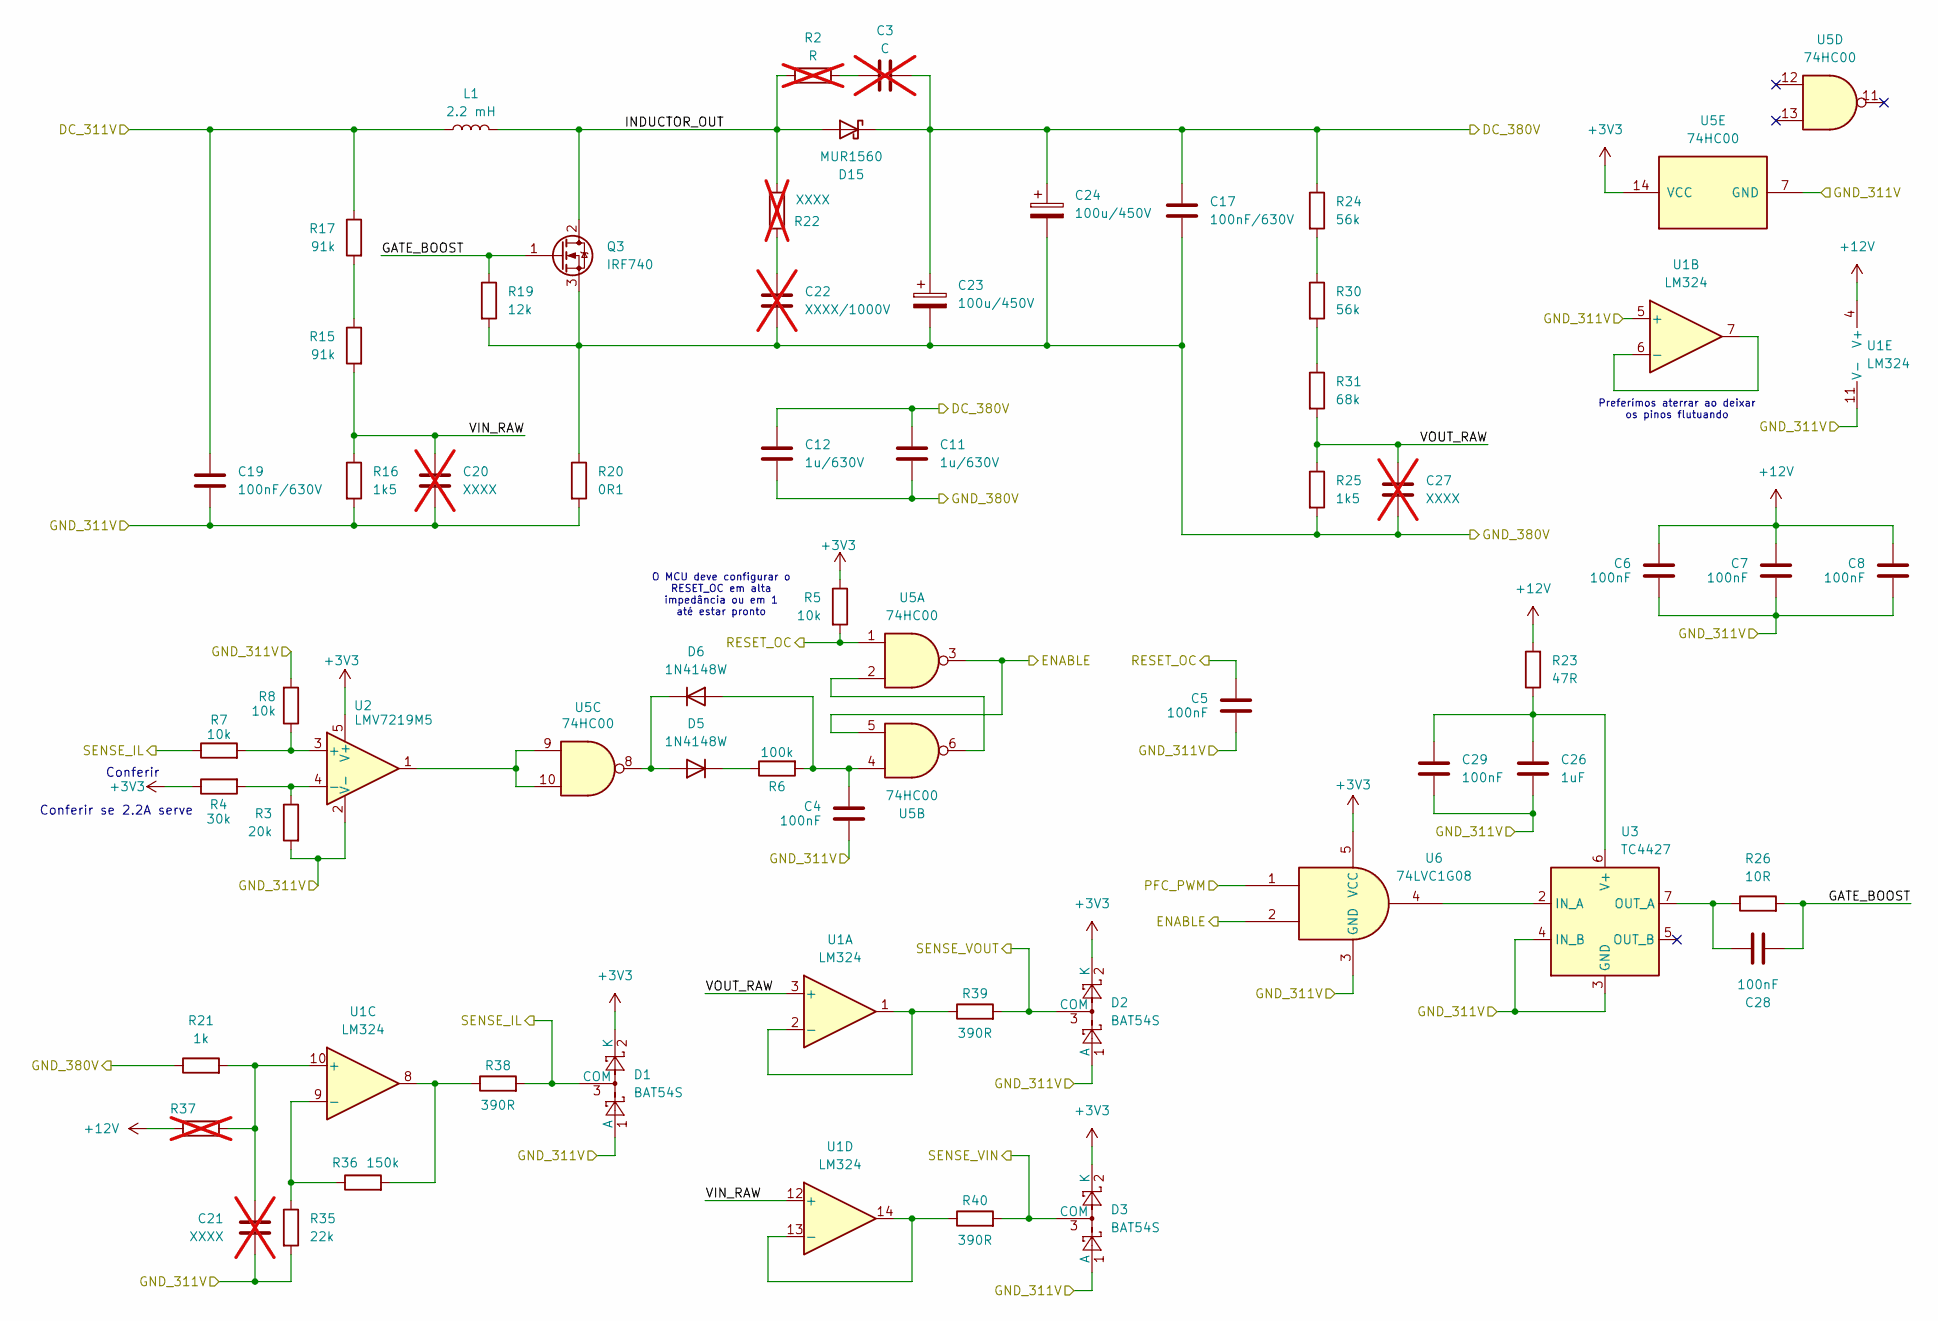
[picture p18: schematic pfc.kicad_sch]

Parts:
C3: C; C_1812_4532Metric_Pad1.57x3.40mm_HandSolder; not fitted
C4, C5, C6, C7, C8, C28, C29: 100nF; C_1206_3216Metric_Pad1.33x1.80mm_HandSolder
C11, C12: 1u/630V; Capacitorzao
C17, C19: 100nF/630V; C_Rect_L18.0mm_W6.0mm_P15.00mm_FKS3_FKP3
C20, C21, C27: XXXX; C_1206_3216Metric_Pad1.33x1.80mm_HandSolder; not fitted
C22: XXXX/1000V; C_1812_4532Metric_Pad1.57x3.40mm_HandSolder; not fitted
C23, C24: 100u/450V; CP_Radial_D18.0mm_P7.50mm
C26: 1uF; C_1206_3216Metric_Pad1.33x1.80mm_HandSolder
D1, D2, D3: BAT54S; SOT-23
D5, D6: 1N4148W; D_SOD-123
D15: MUR1560; TO-220-2_Horizontal_TabUp
L1: 2.2 mH; NEE-30-15-15
Q3: IRF740; TO-220-3_Horizontal_TabUp
R2: R; R_2512_6332Metric_Pad1.40x3.35mm_HandSolder; not fitted
R3: 20k; R_1206_3216Metric_Pad1.30x1.75mm_HandSolder
R4: 30k; R_1206_3216Metric_Pad1.30x1.75mm_HandSolder
R5, R7, R8: 10k; R_1206_3216Metric_Pad1.30x1.75mm_HandSolder
R6: 100k; R_1206_3216Metric_Pad1.30x1.75mm_HandSolder
R15, R17: 91k; R_1206_3216Metric_Pad1.30x1.75mm_HandSolder
R16, R25: 1k5; R_1206_3216Metric_Pad1.30x1.75mm_HandSolder
R19: 12k; R_1206_3216Metric_Pad1.30x1.75mm_HandSolder
R20: 0R1; R_2512_6332Metric_Pad1.40x3.35mm_HandSolder
R21: 1k; R_1206_3216Metric_Pad1.30x1.75mm_HandSolder
R22: XXXX; R_2512_6332Metric_Pad1.40x3.35mm_HandSolder; not fitted
R23: 47R; R_1206_3216Metric_Pad1.30x1.75mm_HandSolder
R24, R30: 56k; R_1206_3216Metric_Pad1.30x1.75mm_HandSolder
R26: 10R; R_1206_3216Metric_Pad1.30x1.75mm_HandSolder
R31: 68k; R_1206_3216Metric_Pad1.30x1.75mm_HandSolder
R35: 22k; R_1206_3216Metric_Pad1.30x1.75mm_HandSolder
R36: 150k; R_1206_3216Metric_Pad1.30x1.75mm_HandSolder
R37: R_1206_3216Metric_Pad1.30x1.75mm_HandSolder; not fitted
R38, R39, R40: 390R; R_1206_3216Metric_Pad1.30x1.75mm_HandSolder
U1: LM324; SOIC-14_3.9x8.7mm_P1.27mm
U2: LMV7219M5; SOT-23-5
U3: TC4427; SOIC-8_3.9x4.9mm_P1.27mm
U5: 74HC00; SOIC-14_3.9x8.7mm_P1.27mm
U6: 74LVC1G08; SOT-23-5_HandSoldering

Connections:
+3V3: D1.2 (K), D2.2 (K), D3.2 (K), R4.1, R5.1, U2.5 (V+), U5.14 (VCC), U6.5 (VCC); also elsewhere on the board
+12V: C6.1, C7.1, C8.1, R23.2, R37.1, U1.4 (V+); also elsewhere on the board
/Low Frequency Rectifier/DC_311V: C19.2, L1.2, R17.1; also elsewhere on the board
/MCU/PA2: U6.1; also elsewhere on the board
/MCU/PA7: D1.3 (COM), R7.1, R38.2; also elsewhere on the board
/MCU/PB0: D2.3 (COM), R39.2; also elsewhere on the board
/MCU/PB1: D3.3 (COM), R40.2; also elsewhere on the board
/PFC/DC_380V: C3.2, C11.2, C12.2, C17.2, C23.1, C24.1, D15.1 (K), R24.1; also elsewhere on the board
/PFC/ENABLE: U5.3, U5.5, U6.2
/PFC/GATE_BOOST: C28.2, Q3.1 (G), R19.1, R26.2
/PFC/GND_380V: C11.1, C12.1, C17.1, C22.2, C23.2, C24.2, C27.2, Q3.3 (S), R19.2, R20.1, R21.1, R25.2; also elsewhere on the board
/PFC/INDUCTOR_OUT: D15.2 (A), L1.1, Q3.2 (D), R2.1, R22.2
/PFC/RESET_OC: C5.1, R5.2, U5.1
/PFC/VIN_RAW: C20.1, R15.2, R16.1, U1.12 (+)
/PFC/VOUT_RAW: C27.1, R25.1, R31.2, U1.3 (+)
GND_311V: C4.2, C5.2, C6.2, C7.2, C8.2, C19.1, C20.2, C21.2, C26.2, C29.2, D1.1 (A), D2.1 (A), D3.1 (A), R3.2, R8.2, R16.2, R20.2, R35.2, U1.5 (+), U1.11 (V-), U2.2 (V-), U3.3 (GND), U3.4 (IN_B), U5.7 (GND), U6.3 (GND); also elsewhere on the board
unnamed: C3.1, R2.2
unnamed: C22.1, R22.1
unnamed: D5.2 (A), D6.1 (K), U5.8
unnamed: D5.1 (K), R6.1
unnamed: C4.1, D6.2 (A), R6.2, U5.4
unnamed: R15.1, R17.2
unnamed: R24.2, R30.1
unnamed: R30.2, R31.1
unnamed: R36.2, R38.1, U1.8
unnamed: R39.1, U1.1, U1.2 (-)
unnamed: U1.6 (-), U1.7
unnamed: C21.1, R21.2, R37.2, U1.10 (+)
unnamed: R35.1, R36.1, U1.9 (-)
unnamed: R40.1, U1.13 (-), U1.14
unnamed: R7.2, R8.1, U2.3 (+)
unnamed: R3.1, R4.2, U2.4 (-)
unnamed: U2.1, U5.9, U5.10
unnamed: U3.2 (IN_A), U6.4
unnamed: C28.1, R26.1, U3.7 (OUT_A)
unnamed: C26.1, C29.1, R23.1, U3.6 (V+)
unnamed: U5.2, U5.6

Notes on the sheet:
Conferir
O MCU deve configurar o RESET_OC em alta impedância ou em 1 até estar pronto
Preferímos aterrar ao deixar os pinos flutuando
Conferir se 2.2A serve

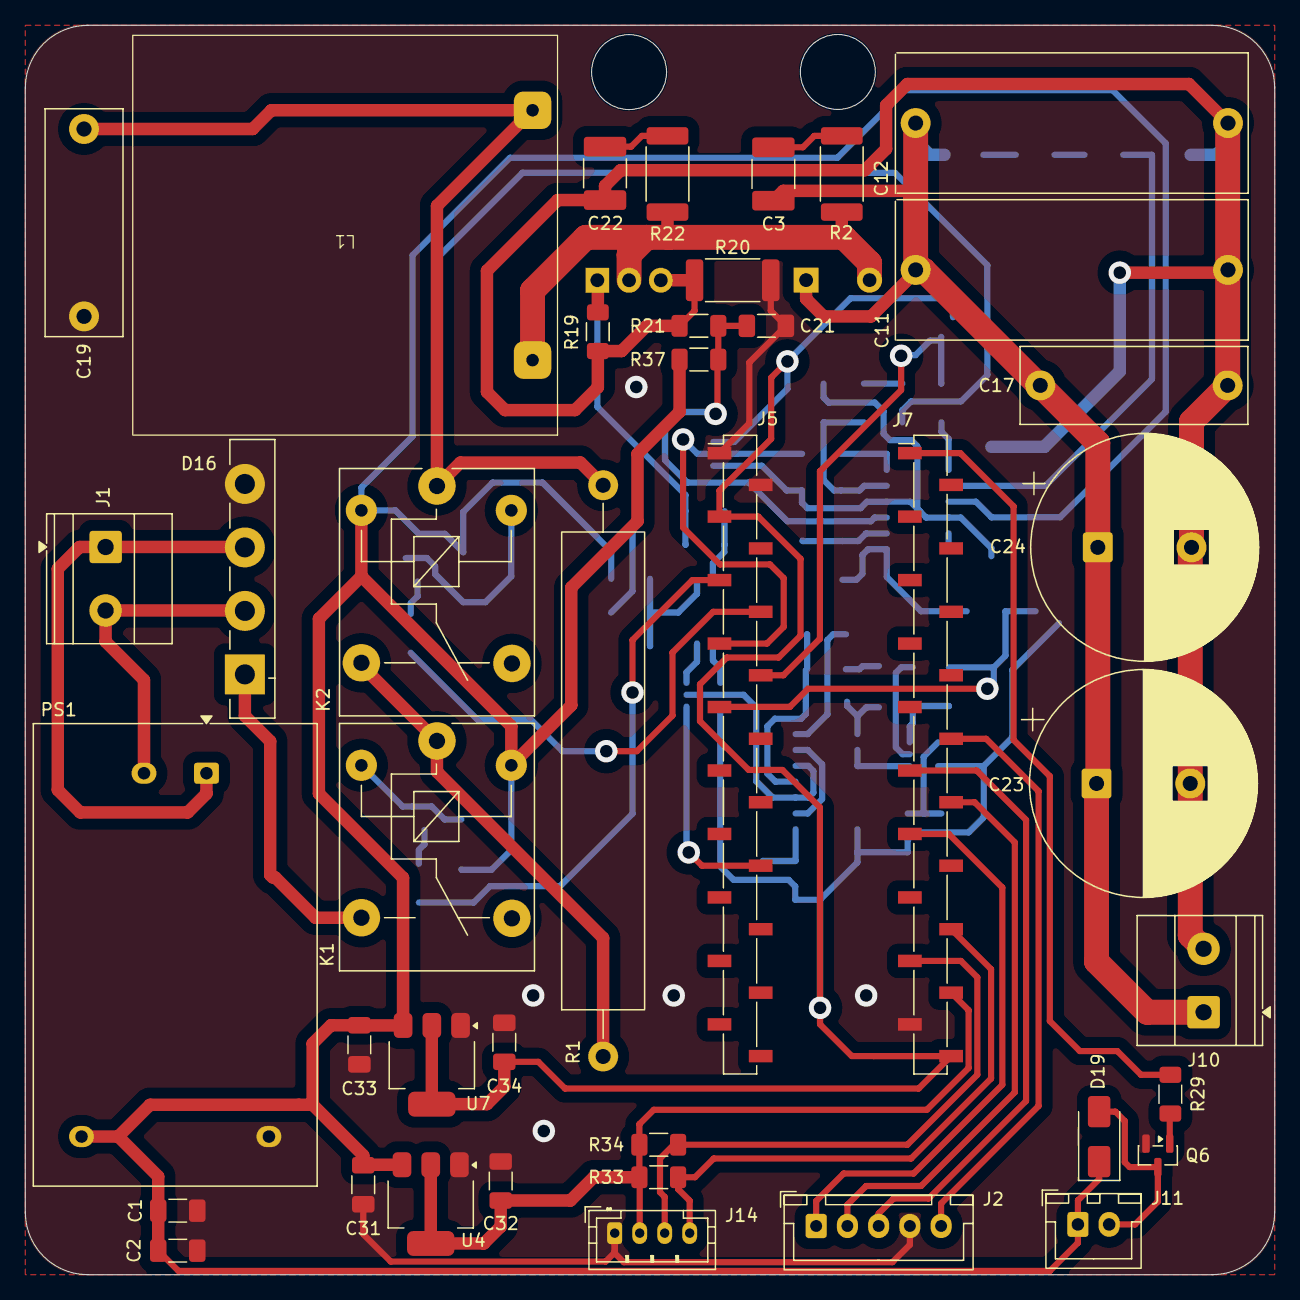
[picture p19: board power-supply.kicad_pcb from above]

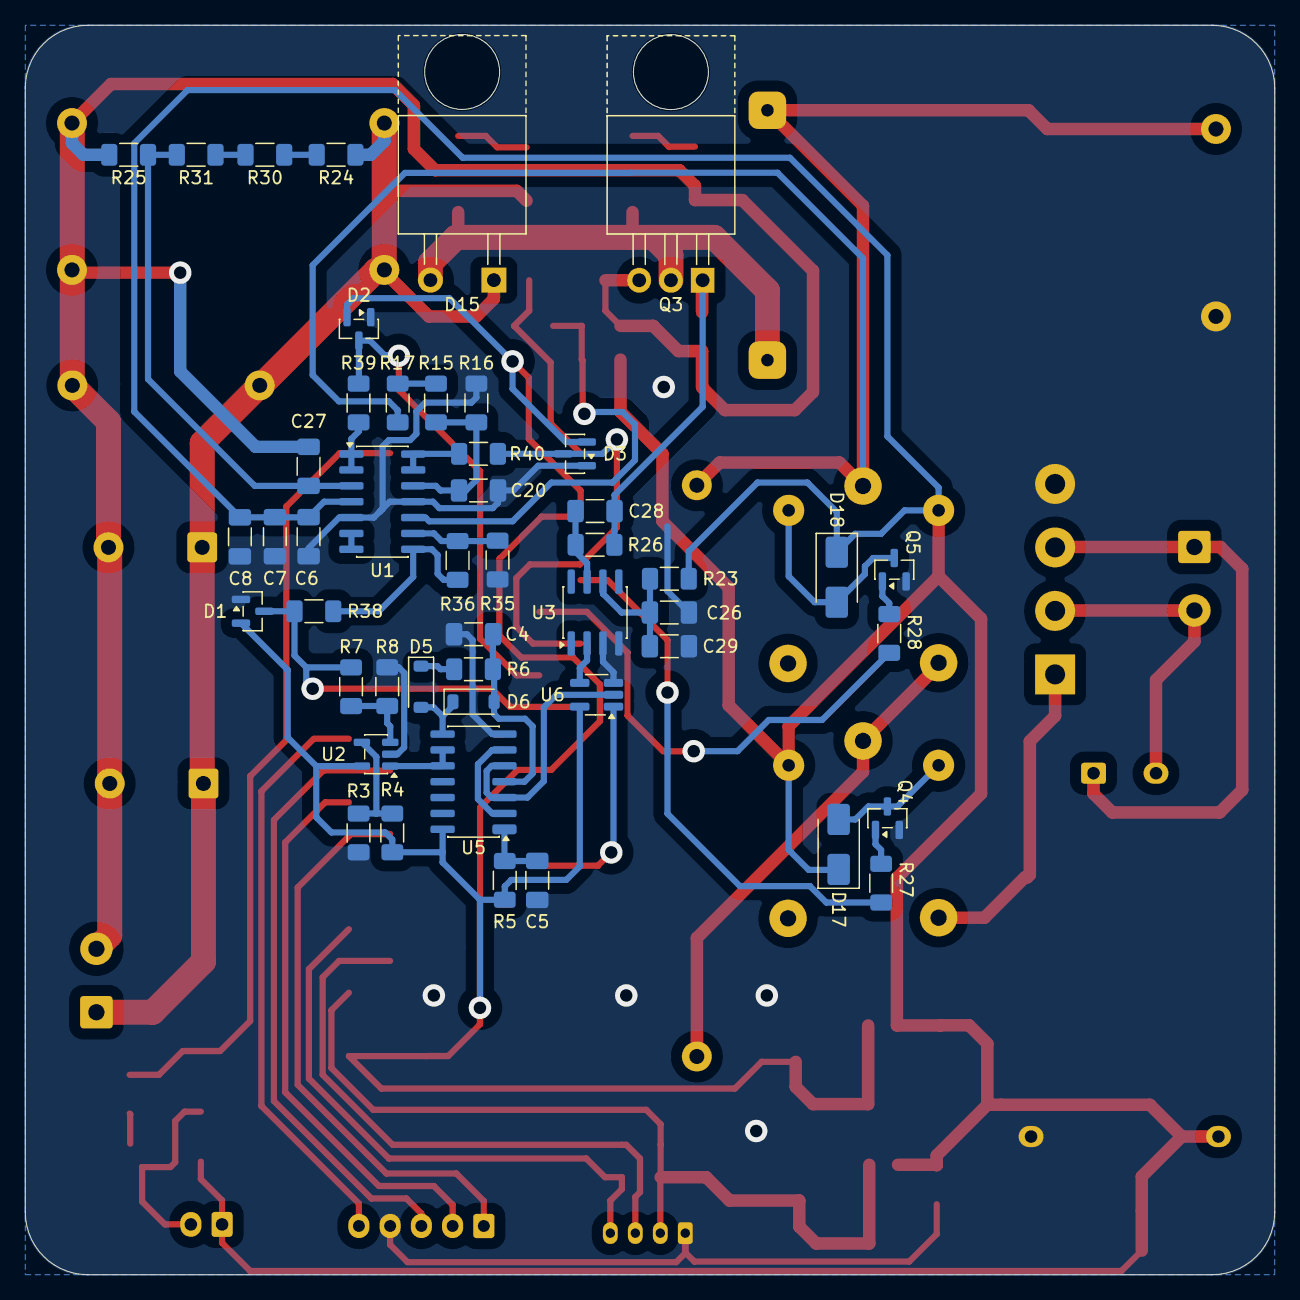
[picture p20: board power-supply.kicad_pcb from below]

Board: 2 copper layers, 100.0 x 100.0 mm, 89 parts (48 on the bottom side), 57 nets.
