gabrielfbdiniz/PFC-Boost-STM32/(commit log)

2026-10-22 docs: add 3D renders, comprehensive README, CERN-OHL-S license, and update PCB routing
    [Blue Pill STM32.step, DG308-2.54-06P-14-00AH.STEP, FuseHolder 5x20mm.step, mcu.kicad_sch, pfc.kicad_sch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]
2026-10-22 pcb: update 3D models for C11/C12, inductor L1, and Blue Pill module with refreshed high-res renders
    [Blue Pill STM32.step, DG308-2.54-06P-14-00AH.STEP, FuseHolder 5x20mm.step, power-supply.kicad_pcb]
2026-10-22 pcb: refine Blue Pill pin alignment, Z-height, and C11/C12 capacitor body dimensions
    [power-supply.kicad_pcb]
2026-10-26 pcb: atualizar layout 2D da placa e esquematicos
    [mcu.kicad_sch, pfc.kicad_sch, power-supply.kicad_pcb, power-supply.kicad_sch]
2026-11-01 feat(pcb): corrigir modelos 3D de C11, C12 e L1, atualizar renderizacoes e documentacao
    - Cria modelo STEP sob medida para C11 e C12 (pitch 25.0mm, L28xW11mm)
    - Cria modelo STEP completo para o indutor L1 (nucleo NEE-30, carretel e enrolamento)
    - Vincula caminhos relativos portateis (/3d/...) no power-supply.kicad_pcb
    - Atualiza renderizacoes 3D em alta resolucao (render_top, render_bottom, render_iso_top, render_iso_bottom)
    - Regenera PDF vetorial do esquematico em docs/
    - Adiciona script e graficos da simulacao de controle (simulate_pfc_control.py)
    - Atualiza arvore do repositorio no README.md
    [Capacitor_THT_L28.0mm_W11.0mm_P25.00mm.step, Inductor_NEE-30-15-15.step, power-supply.kicad_pcb]
2026-11-02 refactor: reorganizar repositorio em hardware, firmware e simulation para integracao com STM32CubeIDE
    [Blue Pill STM32.step, Capacitor_THT_L28.0mm_W11.0mm_P25.00mm.step, DG308-2.54-06P-14-00AH.STEP, FuseHolder 5x20mm.step, Inductor_NEE-30-15-15.step, lf_rectifier.kicad_sch, mcu.kicad_sch, pfc.kicad_sch]
