gabrielfbdiniz/PFC-Boost-STM32/(notices)

Notices in the files:
hardware/3d/Capacitor_THT_L28.0mm_W11.0mm_P25.00mm.step:
Copyright (C) 2017, kicad StepUp
This program is free software: you can redistribute it and/or modify
it under the terms of the GNU General Public License as published by
the Free Software Foundation, either version 3 of the License, or
any later version.
itself might be covered by the GNU General Public License.
README.md:
License: CERN-OHL-S v2
